guoe2012/cECG/ecg_waveform.png

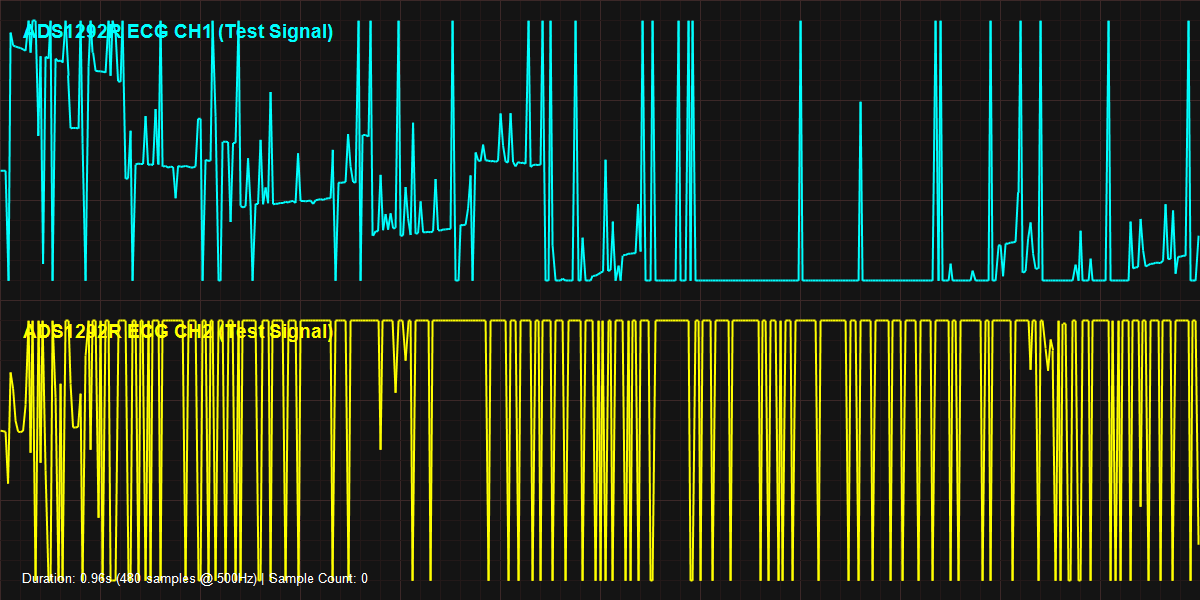
ecg_waveform.png
