guoe2012/cECG/Schematic_V2/Schematic1/SCH_Schematic1_1-sheet_1_Switching DC-DC Conversion_2026-07-18.png

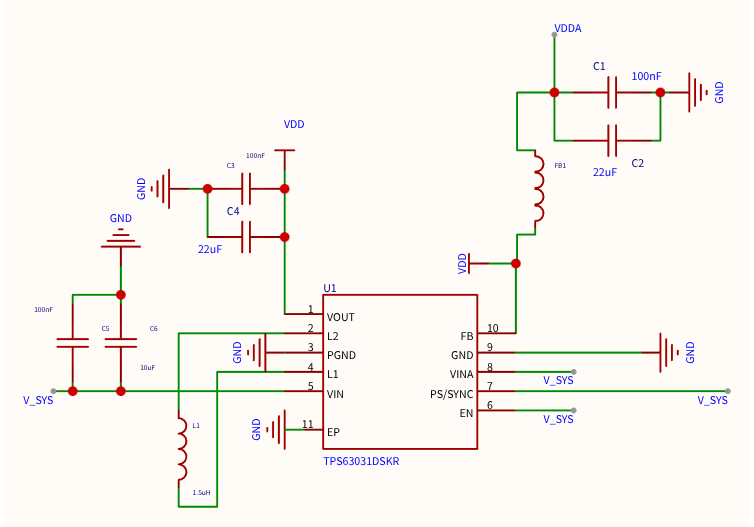
Schematic_V2/Schematic1/SCH_Schematic1_1-sheet_1_Switching DC-DC Conversion_2026-07-18.png
