guoe2012/cECG/Schematic_V2/Schematic1/SCH_Schematic1_2-sheet_2_Battery Management_2026-07-18.png

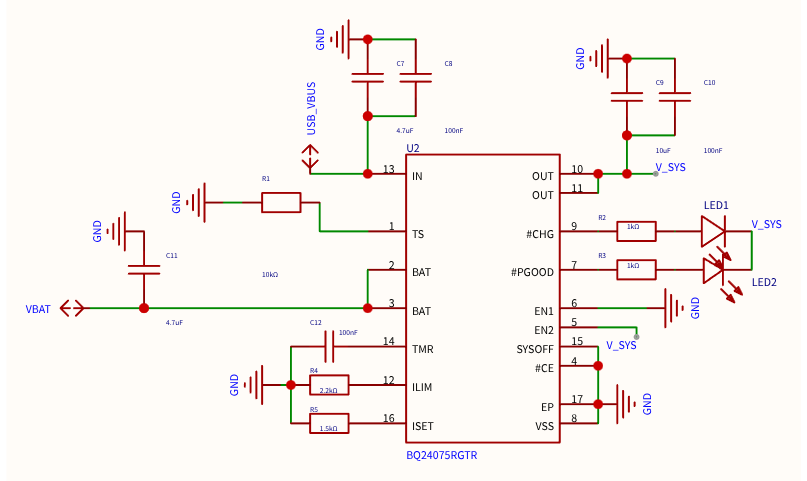
Schematic_V2/Schematic1/SCH_Schematic1_2-sheet_2_Battery Management_2026-07-18.png
