guoe2012/cECG/Schematic_V2/Schematic1/SCH_Schematic1_3-sheet_3_USB Connector_2026-07-18.png

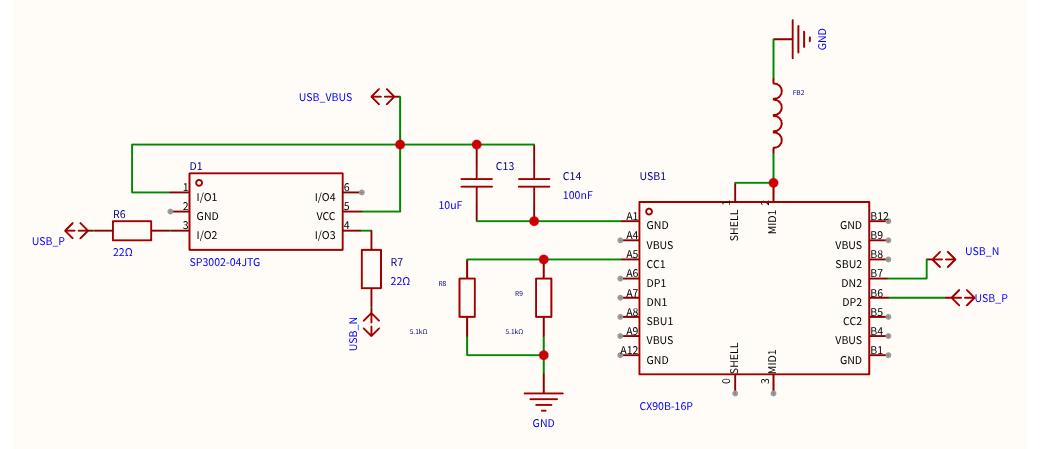
Schematic_V2/Schematic1/SCH_Schematic1_3-sheet_3_USB Connector_2026-07-18.png
