guoe2012/cECG/Schematic_V2/Schematic1/SCH_Schematic1_4-sheet_4_STM32G491RET6 Microcontroller_2026-07-18.png

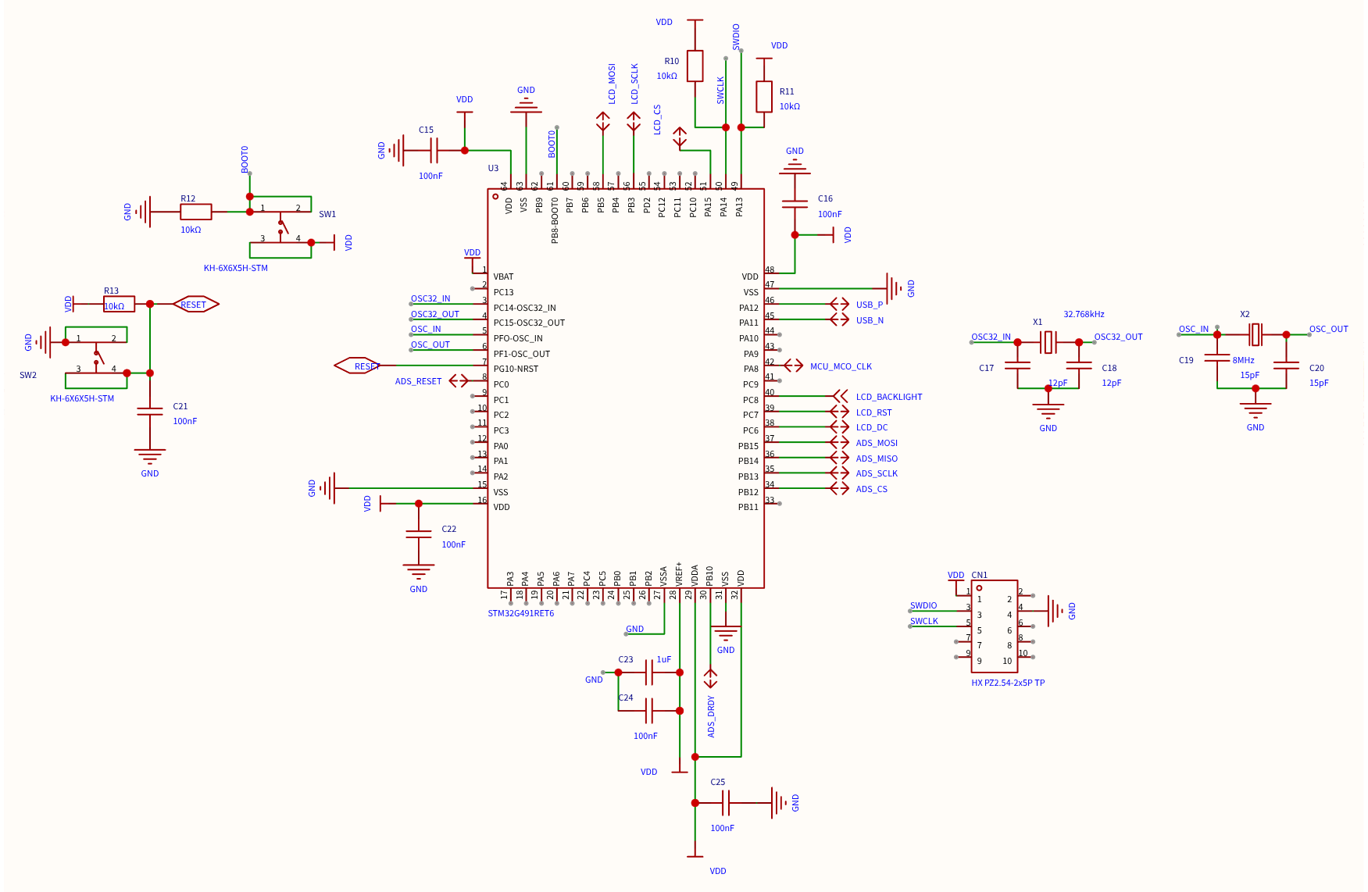
Schematic_V2/Schematic1/SCH_Schematic1_4-sheet_4_STM32G491RET6 Microcontroller_2026-07-18.png
