guoe2012/cECG/Schematic_V2/Schematic1/SCH_Schematic1_5-sheet_6_Batteries_2026-07-18.png

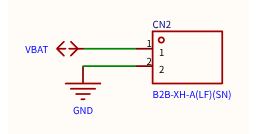
Schematic_V2/Schematic1/SCH_Schematic1_5-sheet_6_Batteries_2026-07-18.png
