guoe2012/cECG/Schematic_V2/Schematic1/SCH_Schematic1_6-sheet_7_Rectangular TFT Display_2026-07-18.png

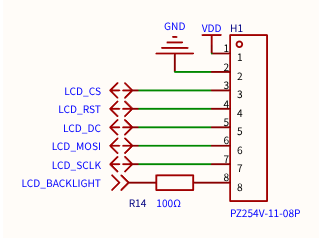
Schematic_V2/Schematic1/SCH_Schematic1_6-sheet_7_Rectangular TFT Display_2026-07-18.png
