guoe2012/cECG/Schematic_V2/Schematic1/SCH_Schematic1_7-sheet_9_ADS1292R_2026-07-18.png

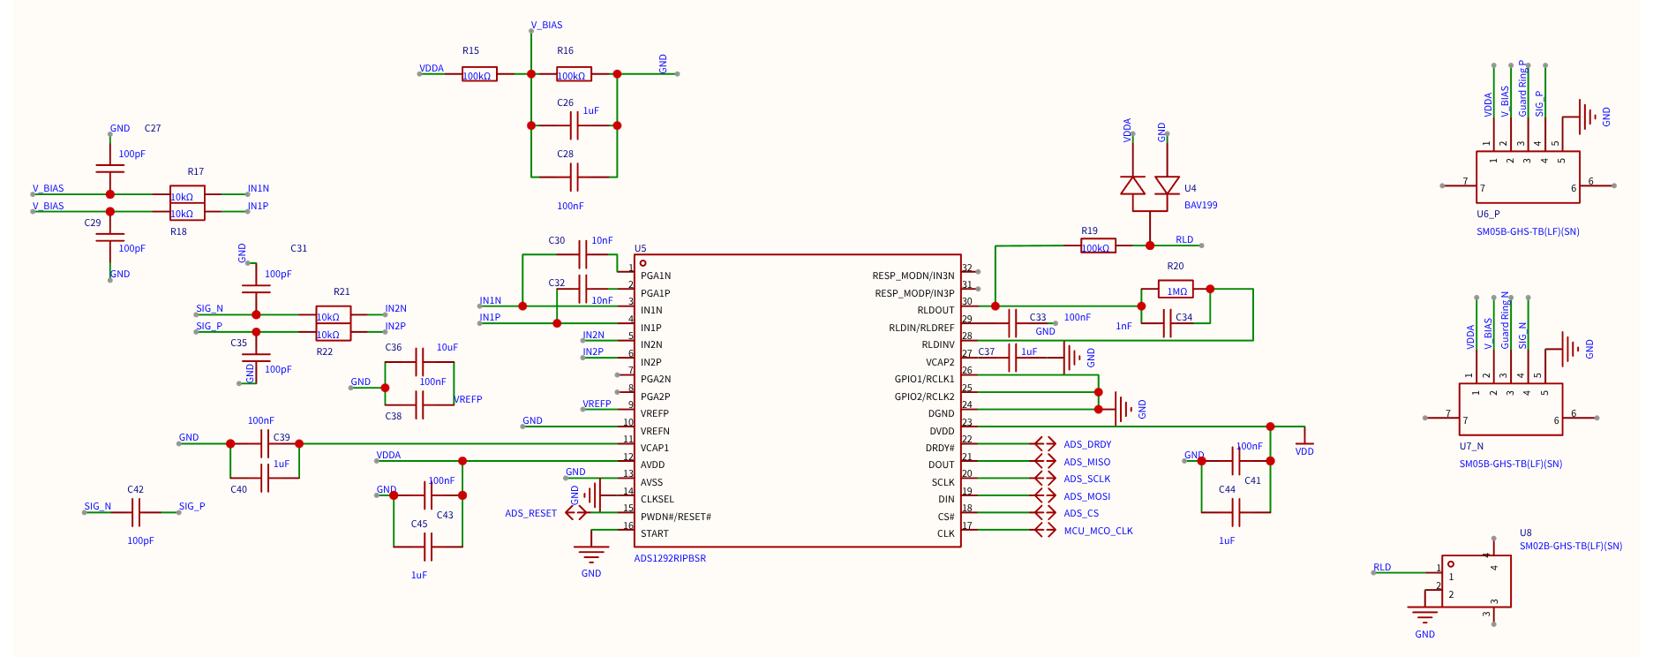
Schematic_V2/Schematic1/SCH_Schematic1_7-sheet_9_ADS1292R_2026-07-18.png
