guoe2012/cECG/Schematic_V2/Schematic2/SCH_Schematic2_1-sheet_5_OPA391_RA_2026-07-18.png

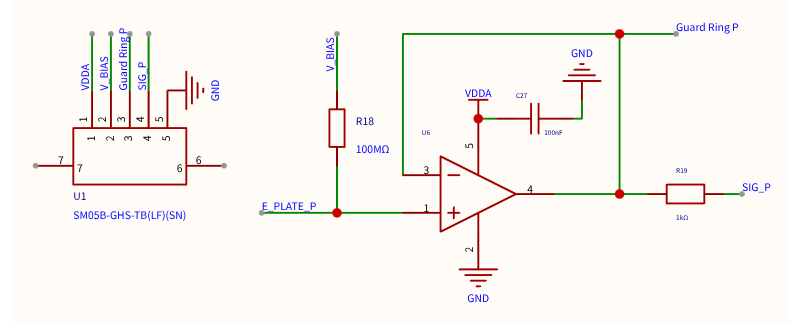
Schematic_V2/Schematic2/SCH_Schematic2_1-sheet_5_OPA391_RA_2026-07-18.png
