guoe2012/cECG/Schematic_V2/Schematic3/SCH_Schematic3_1-sheet_8_OPA391_LA_2026-07-18.png

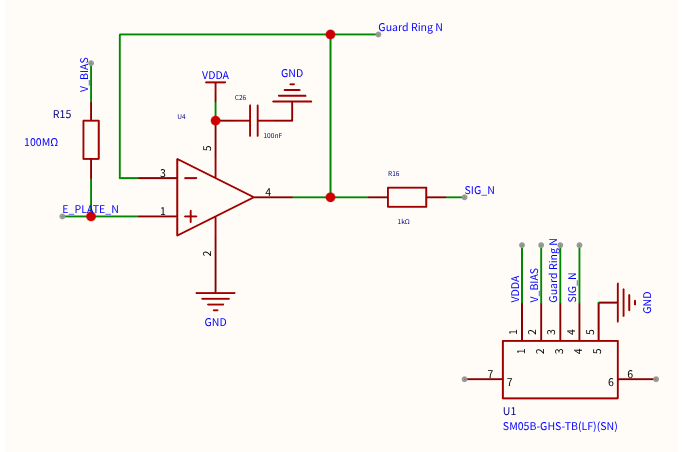
Schematic_V2/Schematic3/SCH_Schematic3_1-sheet_8_OPA391_LA_2026-07-18.png
