guoe2012/cECG/Schematic_V2/Schematic4/SCH_Schematic4_1-P1_2026-07-18.png

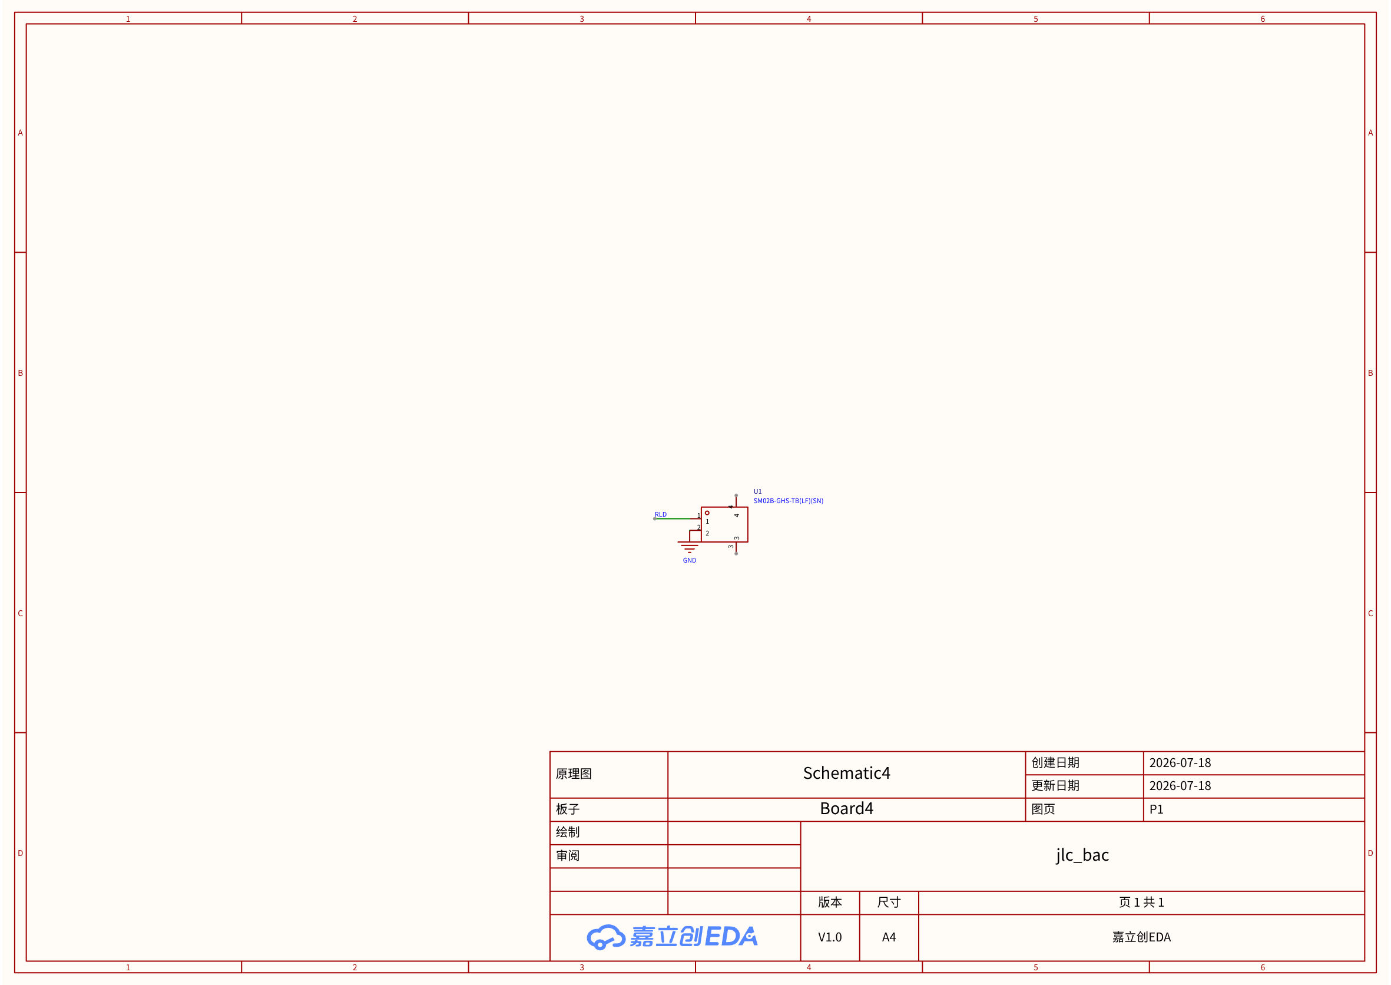
Schematic_V2/Schematic4/SCH_Schematic4_1-P1_2026-07-18.png
