guoe2012/cECG/BOM_Board1_MAIN_PCB1_2026-07-19_V2.xlsx

No. | Quantity | Comment | Designator | Footprint | Value | Manufacturer Part | Manufacturer | Supplier Part | Supplier
1 | 1 | 100nF | C1 | C0603 | 100nF | CGA0603X7R104K500JT | HRE(芯声) | C6119867 | LCSC
2 | 1 | 22uF | C2 | C0603 | 22uF | HGC0603R5226M100NTHJ | Chinocera(华瓷) | C7432770 | LCSC
3 | 1 | 100nF | C3 | C0603 | 100nF | FCC0603B104K500CT | FOJAN(富捷) | C5137636 | LCSC
4 | 1 | 22uF | C4 | C0603 | 22uF | CGA0603X5R226M160JT | HRE(芯声) | C6119868 | LCSC
5 | 1 | 100nF | C5 | C0603 | 100nF | FCC0603B104K500CT | FOJAN(富捷) | C5137636 | LCSC
6 | 1 | 10uF | C6 | C0603 | 10uF | HGC0603R5106M160NTHJ | Chinocera(华瓷) | C7472959 | LCSC
7 | 1 | 4.7uF | C7 | C0603 | 4.7uF | CGA0603X5R475K250JT | HRE(芯声) | C6119856 | LCSC
8 | 1 | 100nF | C8 | C0603 | 100nF | CGA0603X7R104K500JT | HRE(芯声) | C6119867 | LCSC
9 | 1 | 10uF | C9 | C0603 | 10uF | CGA0603X5R106K100JT | HRE(芯声) | C6119842 | LCSC
10 | 1 | 100nF | C10 | C0603 | 100nF | CGA0603X7R104K500JT | HRE(芯声) | C6119867 | LCSC
11 | 1 | 4.7uF | C11 | C0603 | 4.7uF | CGA0603X5R475K250JT | HRE(芯声) | C6119856 | LCSC
12 | 1 | 100nF | C13 | C0603 | 100nF | CC0603KRX7R9BB104 | YAGEO(国巨) | C14663 | LCSC
13 | 1 | 10uF | C14 | C0603 | 10uF | HGC0603R5106M160NTHJ | Chinocera(华瓷) | C7472959 | LCSC
14 | 1 | 100nF | C15 | C0603 | 100nF | CC0603KRX7R9BB104 | YAGEO(国巨) | C14663 | LCSC
15 | 1 | 100nF | C16 | C0603 | 100nF | CC0603KRX7R9BB104 | YAGEO(国巨) | C14663 | LCSC
16 | 1 | 12pF | C17 | C0603 | 12pF | CL10C120JB8NNNC | SAMSUNG(三星) | C38523 | LCSC
17 | 1 | 12pF | C18 | C0603 | 12pF | CL10C120JB8NNNC | SAMSUNG(三星) | C38523 | LCSC
18 | 1 | 15pF | C19 | C0603 | 15pF | CL10C150JB8NNNC | SAMSUNG(三星) | C1644 | LCSC
19 | 1 | 15pF | C20 | C0603 | 15pF | CL10C150JB8NNNC | SAMSUNG(三星) | C1644 | LCSC
20 | 1 | 100nF | C21 | C0603 | 100nF | CC0603KRX7R9BB104 | YAGEO(国巨) | C14663 | LCSC
21 | 1 | 100nF | C22 | C0603 | 100nF | CC0603KRX7R9BB104 | YAGEO(国巨) | C14663 | LCSC
22 | 1 | 1uF | C23 | C0603 | 1uF | CGA0603X5R105K160JT | HRE(芯声) | C6119849 | LCSC
23 | 1 | 100nF | C24 | C0603 | 100nF | CC0603KRX7R9BB104 | YAGEO(国巨) | C14663 | LCSC
24 | 1 | 100nF | C25 | C0603 | 100nF | CC0603KRX7R9BB104 | YAGEO(国巨) | C14663 | LCSC
25 | 1 | 1uF | C26 | C0603 | 1uF | CC0603KRX7R9BB105 | YAGEO(国巨) | C559769 | LCSC
26 | 1 | 100pF | C27 | C0603 | 100pF | CL10C101JB8NNNC | SAMSUNG(三星) | C14858 | LCSC
27 | 1 | 100nF | C28 | C0603 | 100nF | CC0603KRX7R9BB104 | YAGEO(国巨) | C14663 | LCSC
28 | 1 | 100pF | C29 | C0603 | 100pF | CL10C101JB8NNNC | SAMSUNG(三星) | C14858 | LCSC
29 | 1 | 10nF | C30 | C0603 | 10nF | CC0603KRX7R9BB103 | YAGEO(国巨) | C100042 | LCSC
30 | 1 | 100pF | C31 | C0603 | 100pF | CL10C101JB8NNNC | SAMSUNG(三星) | C14858 | LCSC
31 | 1 | 10nF | C32 | C0603 | 10nF | CC0603KRX7R9BB103 | YAGEO(国巨) | C100042 | LCSC
32 | 1 | 100nF | C33 | C0603 | 100nF | CC0603KRX7R9BB104 | YAGEO(国巨) | C14663 | LCSC
33 | 1 | 1nF | C34 | C0603 | 1nF | CC0603JRNPO9BN102 | YAGEO(国巨) | C106246 | LCSC
34 | 1 | 100pF | C35 | C0603 | 100pF | CL10C101JB8NNNC | SAMSUNG(三星) | C14858 | LCSC
35 | 1 | 10uF | C36 | C0603 | 10uF | HGC0603R5106M160NTHJ | Chinocera(华瓷) | C7472959 | LCSC
36 | 1 | 1uF | C37 | C0603 | 1uF | CC0603KRX7R9BB105 | YAGEO(国巨) | C559769 | LCSC
37 | 1 | 100nF | C38 | C0603 | 100nF | CC0603KRX7R9BB104 | YAGEO(国巨) | C14663 | LCSC
38 | 1 | 100nF | C39 | C0603 | 100nF | CC0603KRX7R9BB104 | YAGEO(国巨) | C14663 | LCSC
39 | 1 | 1uF | C40 | C0603 | 1uF | CC0603KRX7R9BB105 | YAGEO(国巨) | C559769 | LCSC
40 | 1 | 100nF | C41 | C0603 | 100nF | CC0603KRX7R9BB104 | YAGEO(国巨) | C14663 | LCSC
41 | 1 | 100pF | C42 | C0603 | 100pF | CL10C101JB8NNNC | SAMSUNG(三星) | C14858 | LCSC
42 | 1 | 100nF | C43 | C0603 | 100nF | CC0603KRX7R9BB104 | YAGEO(国巨) | C14663 | LCSC
43 | 1 | 1uF | C44 | C0603 | 1uF | CC0603KRX7R9BB105 | YAGEO(国巨) | C559769 | LCSC
44 | 1 | 1uF | C45 | C0603 | 1uF | CC0603KRX7R9BB105 | YAGEO(国巨) | C559769 | LCSC
45 | 1 | HX PZ2.54-2x5P TP | CN1 | HDR-SMD_10P-P2.54-V-M-R2-C5-LS7.5 |  | HX PZ2.54-2x5P TP | hanxia(韩下) | C32713285 | LCSC
46 | 1 | B2B-XH-A(LF)(SN) | CN2 | CONN-TH_B2B-XH-A-LF-SN |  | B2B-XH-A(LF)(SN) | JST | C158012 | LCSC
47 | 1 | SP3002-04JTG | D1 | SC-70-6_L2.2-W1.3-P0.65-LS2.1-BR |  | SP3002-04JTG | Littelfuse(美国力特) | C84558 | LCSC
48 | 1 | BLM18PG121SN1D | FB1 | L0603 |  | BLM18PG121SN1D | muRata(村田) | C14709 | LCSC
49 | 1 | BLM18PG121SN1D | FB2 | L0603 |  | BLM18PG121SN1D | muRata(村田) | C14709 | LCSC
50 | 1 | PZ254V-11-08P | H1 | HDR-TH_8P-P2.54-V-M |  | PZ254V-11-08P | XFCN(兴飞) | C492407 | LCSC
51 | 1 | 1.5uH | L1 | IND-SMD_L4.6-W4.1_SRG0420 | 1.5uH | SRG0420-1R5-M | JIERR(捷而瑞) | C53462915 | LCSC
52 | 1 | LTST-C170KRKT | LED1 | LED0805-R-RD |  | LTST-C170KRKT | LITEON(光宝) | C94868 | LCSC
53 | 1 | LTST-C170KGKT | LED2 | LED0805-R-RD |  | LTST-C170KGKT | LITEON(光宝) | C98221 | LCSC
54 | 1 | 10kΩ | R1 | R0603 | 10kΩ | FRC0603J103 TS | FOJAN(富捷) | C2930027 | LCSC
55 | 1 | 1kΩ | R2 | R0603 | 1kΩ | FRC0603F1001TS | FOJAN(富捷) | C2907002 | LCSC
56 | 1 | 1kΩ | R3 | R0603 | 1kΩ | FRC0603F1001TS | FOJAN(富捷) | C2907002 | LCSC
57 | 1 | 2.2kΩ | R4 | R0603 | 2.2kΩ | FRC0603F2201TS | FOJAN(富捷) | C2907005 | LCSC
58 | 1 | 1.5kΩ | R5 | R0603 | 1.5kΩ | FRC0603F1501TS | FOJAN(富捷) | C2930050 | LCSC
59 | 1 | 5.1kΩ | R6 | R0603 | 5.1kΩ | 0603WAF5101T5E | UNI-ROYAL(厚声) | C23186 | LCSC
60 | 1 | 5.1kΩ | R8 | R0603 | 5.1kΩ | 0603WAF5101T5E | UNI-ROYAL(厚声) | C23186 | LCSC
61 | 1 | 10kΩ | R10 | R0603 | 10kΩ | FRC0603J103 TS | FOJAN(富捷) | C2930027 | LCSC
62 | 1 | 10kΩ | R11 | R0603 | 10kΩ | FRC0603J103 TS | FOJAN(富捷) | C2930027 | LCSC
63 | 1 | 10kΩ | R12 | R0603 | 10kΩ | FRC0603J103 TS | FOJAN(富捷) | C2930027 | LCSC
64 | 1 | 10kΩ | R13 | R0603 | 10kΩ | FRC0603J103 TS | FOJAN(富捷) | C2930027 | LCSC
65 | 1 | 100Ω | R14 | R0603 | 100Ω | RC0603FR-07100RL | YAGEO(国巨) | C105588 | LCSC
66 | 1 | 100kΩ | R15 | R0603 | 100kΩ | 0603WAF1003T5E | UNI-ROYAL(厚声) | C25803 | LCSC
67 | 1 | 100kΩ | R16 | R0603 | 100kΩ | 0603WAF1003T5E | UNI-ROYAL(厚声) | C25803 | LCSC
68 | 1 | 10kΩ | R17 | R0603 | 10kΩ | FRC0603F1002TS | FOJAN(富捷) | C2906982 | LCSC
69 | 1 | 10kΩ | R18 | R0603 | 10kΩ | FRC0603F1002TS | FOJAN(富捷) | C2906982 | LCSC
70 | 1 | 100kΩ | R19 | R0603 | 100kΩ | RC0603FR-07100KL | YAGEO(国巨) | C14675 | LCSC
71 | 1 | 1MΩ | R20 | R0603 | 1MΩ | FRR0603J105 TS | FOJAN(富捷) | C49196795 | LCSC
72 | 1 | 10kΩ | R21 | R0603 | 10kΩ | FRC0603F1002TS | FOJAN(富捷) | C2906982 | LCSC
73 | 1 | 10kΩ | R22 | R0603 | 10kΩ | FRC0603F1002TS | FOJAN(富捷) | C2906982 | LCSC
74 | 1 | KH-6X6X5H-STM | SW1 | SW-SMD_4P-L6.0-W6.0-P4.50-LS9.0_H5.0 |  | KH-6X6X5H-STM | kinghelm(金航标) | C2837531 | LCSC
75 | 1 | KH-6X6X5H-STM | SW2 | SW-SMD_4P-L6.0-W6.0-P4.50-LS9.0_H5.0 |  | KH-6X6X5H-STM | kinghelm(金航标) | C2837531 | LCSC
76 | 1 | TPS63031DSKR | U1 | SON-10_L2.5-W2.5-P0.50-TL-EP |  | TPS63031DSKR | TI(德州仪器) | C15516 | LCSC
77 | 1 | BQ24075RGTR | U2 | QFN-16_L3.0-W3.0-P0.50-TL-EP1.7 |  | BQ24075RGTR | TI(德州仪器) | C15464 | LCSC
78 | 1 | STM32G491RET6 | U3 | LQFP-64_L10.0-W10.0-P0.50-LS12.0-BL |  | STM32G491RET6 | ST(意法半导体) | C3231005 | LCSC
79 | 1 | BAV199 | U4 | SOT-23-3_L2.9-W1.3-P0.95-LS2.4-BR |  | BAV199 | HXY MOSFET(华轩阳电子) | C5184419 | LCSC
80 | 1 | ADS1292RIPBSR | U5 | TQFP-32_L5.0-W5.0-P0.50-LS7.0-TL |  | ADS1292RIPBSR | TI(德州仪器) | C528635 | LCSC
81 | 1 | SM05B-GHS-TB(LF)(SN) | U6_P | CONN-SMD_5P-P1.25_SM05B-GHS-TB-LF-SN |  | SM05B-GHS-TB(LF)(SN) | JST | C189896 | LCSC
82 | 1 | SM05B-GHS-TB(LF)(SN) | U7_N | CONN-SMD_5P-P1.25_SM05B-GHS-TB-LF-SN |  | SM05B-GHS-TB(LF)(SN) | JST | C189896 | LCSC
83 | 1 | SM02B-GHS-TB(LF)(SN) | U8 | CONN-SMD_SM02B-GHS-TB-LF-SN |  | SM02B-GHS-TB(LF)(SN) | JST | C189893 | LCSC
84 | 1 | CX90B-16P | USB2 | USB-C-SMD_CX90B-16P |  | CX90B-16P | HRS(广濑) | C3198004 | LCSC
85 | 1 | 32.768kHz | X1 | OSC-SMD_L3.2-W1.5 | 32.768kHz | X321532768KGD2SI | YXC(扬兴晶振) | C620155 | LCSC
86 | 1 | 8MHz | X2 | CRYSTAL-SMD_L3.2-W2.5_3225-8MHZ | 8MHz | X22EL89COI-111YLC-8M | YXC(扬兴晶振) | C42448903 | LCSC
