guoe2012/cECG/build_log.txt

make: Entering directory 'C:/Users/guoe2/Documents/cECG/Debug'
rm -rf ./Src/ads1292r_test.cyclo ./Src/ads1292r_test.d ./Src/ads1292r_test.o ./Src/ads1292r_test.su ./Src/ads_connect_test.cyclo ./Src/ads_connect_test.d ./Src/ads_connect_test.o ./Src/ads_connect_test.su ./Src/ecg_acquisition.cyclo ./Src/ecg_acquisition.d ./Src/ecg_acquisition.o ./Src/ecg_acquisition.su ./Src/ili9488.cyclo ./Src/ili9488.d ./Src/ili9488.o ./Src/ili9488.su ./Src/main.cyclo ./Src/main.d ./Src/main.o ./Src/main.su ./Src/stm32g4xx_hal_msp.cyclo ./Src/stm32g4xx_hal_msp.d ./Src/stm32g4xx_hal_msp.o ./Src/stm32g4xx_hal_msp.su ./Src/stm32g4xx_it.cyclo ./Src/stm32g4xx_it.d ./Src/stm32g4xx_it.o ./Src/stm32g4xx_it.su ./Src/system_stm32g4xx.cyclo ./Src/system_stm32g4xx.d ./Src/system_stm32g4xx.o ./Src/system_stm32g4xx.su
rm -rf ./Drivers/STM32G4xx_HAL_Driver/Src/stm32g4xx_hal.cyclo ./Drivers/STM32G4xx_HAL_Driver/Src/stm32g4xx_hal.d ./Drivers/STM32G4xx_HAL_Driver/Src/stm32g4xx_hal.o ./Drivers/STM32G4xx_HAL_Driver/Src/stm32g4xx_hal.su ./Drivers/STM32G4xx_HAL_Driver/Src/stm32g4xx_hal_adc.cyclo ./Drivers/STM32G4xx_HAL_Driver/Src/stm32g4xx_hal_adc.d ./Drivers/STM32G4xx_HAL_Driver/Src/stm32g4xx_hal_adc.o ./Drivers/STM32G4xx_HAL_Driver/Src/stm32g4xx_hal_adc.su ./Drivers/STM32G4xx_HAL_Driver/Src/stm32g4xx_hal_adc_ex.cyclo ./Drivers/STM32G4xx_HAL_Driver/Src/stm32g4xx_hal_adc_ex.d ./Drivers/STM32G4xx_HAL_Driver/Src/stm32g4xx_hal_adc_ex.o ./Drivers/STM32G4xx_HAL_Driver/Src/stm32g4xx_hal_adc_ex.su ./Drivers/STM32G4xx_HAL_Driver/Src/stm32g4xx_hal_comp.cyclo ./Drivers/STM32G4xx_HAL_Driver/Src/stm32g4xx_hal_comp.d ./Drivers/STM32G4xx_HAL_Driver/Src/stm32g4xx_hal_comp.o ./Drivers/STM32G4xx_HAL_Driver/Src/stm32g4xx_hal_comp.su ./Drivers/STM32G4xx_HAL_Driver/Src/stm32g4xx_hal_cordic.cyclo ./Drivers/STM32G4xx_HAL_Driver/Src/stm32g4xx_hal_cordic.d ./Drivers/STM32G4xx_HAL_Driver/Src/stm32g4xx_hal_cordic.o ./Drivers/STM32G4xx_HAL_Driver/Src/stm32g4xx_hal_cordic.su ./Drivers/STM32G4xx_HAL_Driver/Src/stm32g4xx_hal_cortex.cyclo ./Drivers/STM32G4xx_HAL_Driver/Src/stm32g4xx_hal_cortex.d ./Drivers/STM32G4xx_HAL_Driver/Src/stm32g4xx_hal_cortex.o ./Drivers/STM32G4xx_HAL_Driver/Src/stm32g4xx_hal_cortex.su ./Drivers/STM32G4xx_HAL_Driver/Src/stm32g4xx_hal_crc.cyclo ./Drivers/STM32G4xx_HAL_Driver/Src/stm32g4xx_hal_crc.d ./Dri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
rm -rf ./Drivers/STM32G4xx_HAL_Driver/Src/stm32g4xx_ll_rng.d ./Drivers/STM32G4xx_HAL_Driver/Src/stm32g4xx_ll_rng.o ./Drivers/STM32G4xx_HAL_Driver/Src/stm32g4xx_ll_rng.su ./Drivers/STM32G4xx_HAL_Driver/Src/stm32g4xx_ll_rtc.cyclo ./Drivers/STM32G4xx_HAL_Driver/Src/stm32g4xx_ll_rtc.d ./Drivers/STM32G4xx_HAL_Driver/Src/stm32g4xx_ll_rtc.o ./Drivers/STM32G4xx_HAL_Driver/Src/stm32g4xx_ll_rtc.su ./Drivers/STM32G4xx_HAL_Driver/Src/stm32g4xx_ll_spi.cyclo ./Drivers/STM32G4xx_HAL_Driver/Src/stm32g4xx_ll_spi.d ./Drivers/STM32G4xx_HAL_Driver/Src/stm32g4xx_ll_spi.o ./Drivers/STM32G4xx_HAL_Driver/Src/stm32g4xx_ll_spi.su ./Drivers/STM32G4xx_HAL_Driver/Src/stm32g4xx_ll_tim.cyclo ./Drivers/STM32G4xx_HAL_Driver/Src/stm32g4xx_ll_tim.d ./Drivers/STM32G4xx_HAL_Driver/Src/stm32g4xx_ll_tim.o ./Drivers/STM32G4xx_HAL_Driver/Src/stm32g4xx_ll_tim.su ./Drivers/STM32G4xx_HAL_Driver/Src/stm32g4xx_ll_ucpd.cyclo ./Drivers/STM32G4xx_HAL_Driver/Src/stm32g4xx_ll_ucpd.d ./Drivers/STM32G4xx_HAL_Driver/Src/stm32g4xx_ll_ucpd.o ./Drivers/STM32G4xx_HAL_Driver/Src/stm32g4xx_ll_ucpd.su ./Drivers/STM32G4xx_HAL_Driver/Src/stm32g4xx_ll_usart.cyclo ./Drivers/STM32G4xx_HAL_Driver/Src/stm32g4xx_ll_usart.d ./Drivers/STM32G4xx_HAL_Driver/Src/stm32g4xx_ll_usart.o ./Drivers/STM32G4xx_HAL_Driver/Src/stm32g4xx_ll_usart.su ./Drivers/STM32G4xx_HAL_Driver/Src/stm32g4xx_ll_usb.cyclo ./Drivers/STM32G4xx_HAL_Driver/Src/stm32g4xx_ll_usb.d ./Drivers/STM32G4xx_HAL_Driver/Src/stm32g4xx_ll_usb.o ./Drivers/STM32G4xx_HAL_Driver/Src/stm32g4xx_ll_usb.su ./Drivers/STM32G4xx_HAL_Driver/Src/stm32g4xx_ll_utils.cyclo ./Drivers/STM32G4xx_HAL_Driver/Src/stm32g4xx_ll_utils.d ./Drivers/STM32G4xx_HAL_Driver/Src/stm32g4xx_ll_utils.o ./Drivers/STM32G4xx_HAL_Driver/Src/stm32g4xx_ll_utils.su
rm -rf ./startup_stm32g491xx.d ./startup_stm32g491xx.o
rm -rf cECG.elf cECG.list cECG.map default.size.stdout
 
make: Leaving directory 'C:/Users/guoe2/Documents/cECG/Debug'
