guoe2012/cECG/Schematic_V1/SCH_Schematic1_2026-07-15.pdf

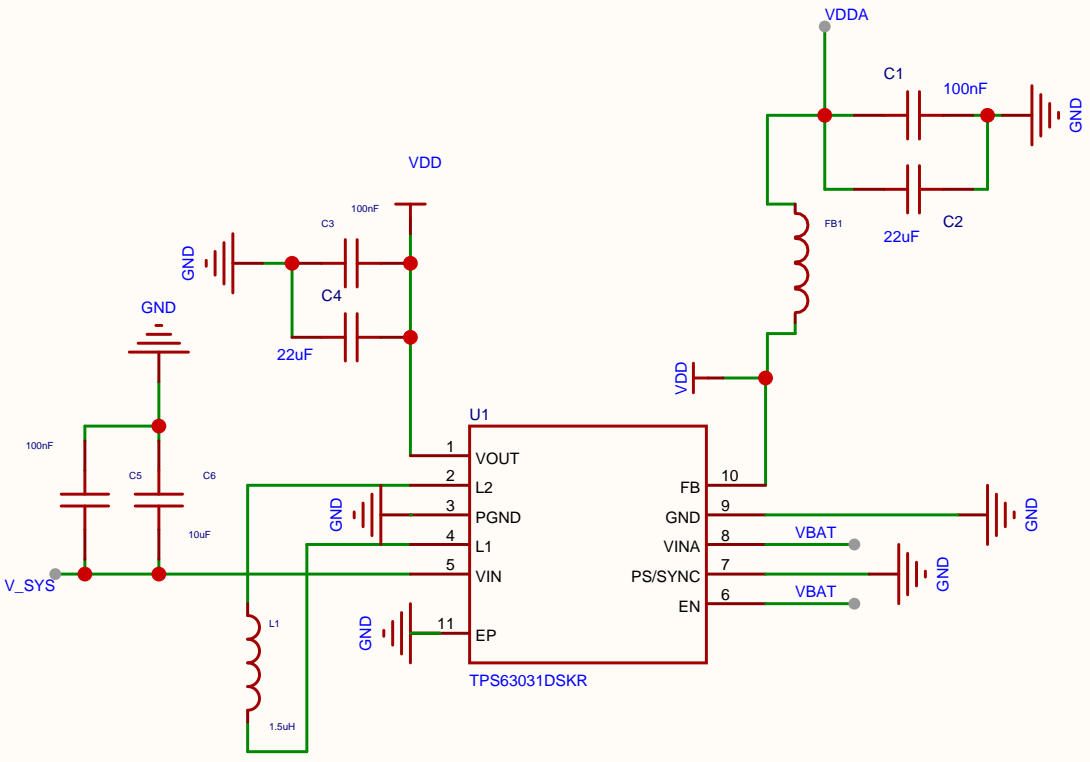
[picture p12: page 1]

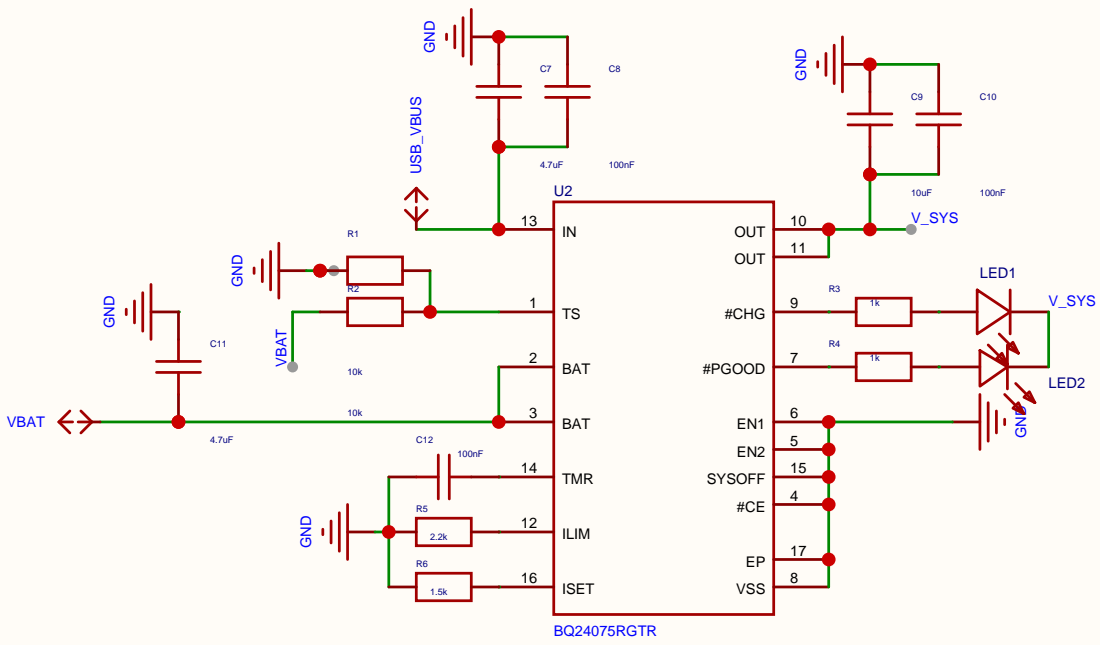
[picture p13: page 2]

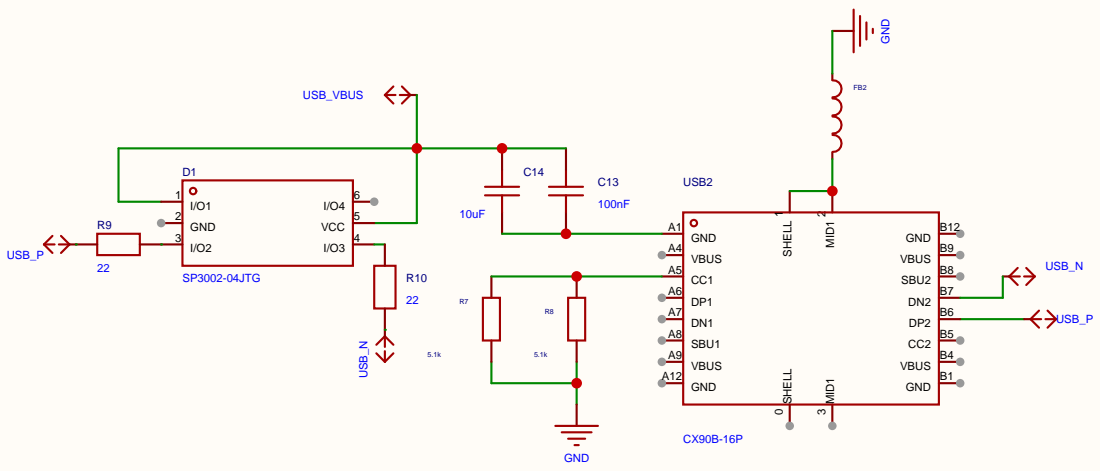
[picture p14: page 3]

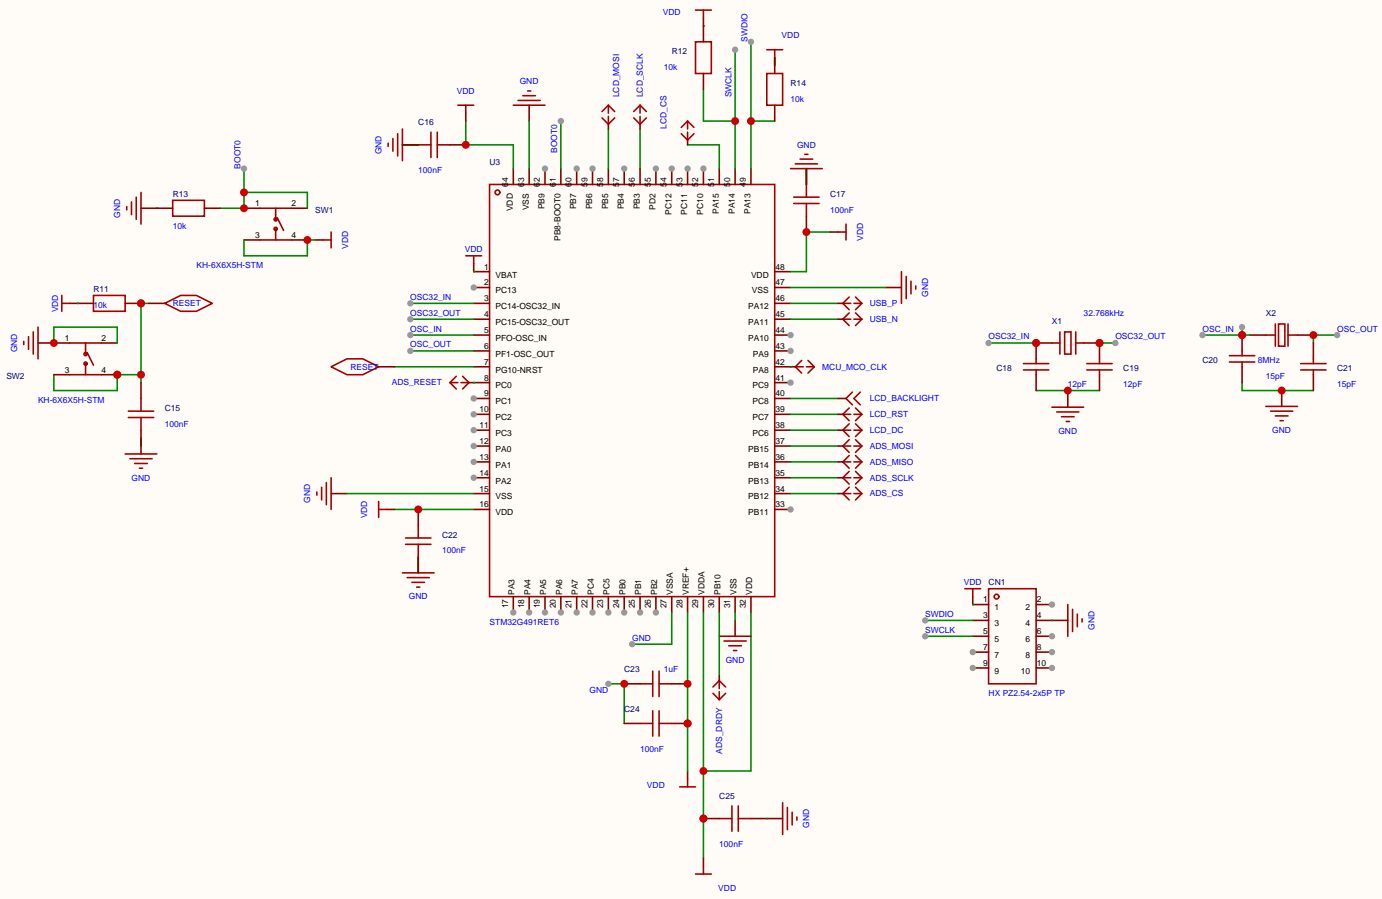
[picture p15: page 4]

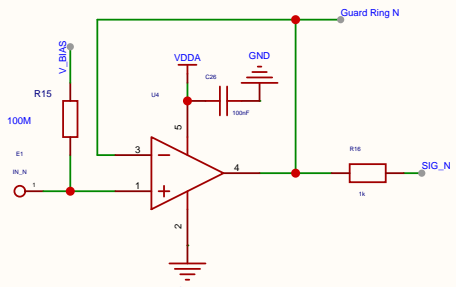
[picture p16: figure]
SIG_N; VDDA; Guard Ring N; GND; V_BIAS

CN2



GND

VBAT

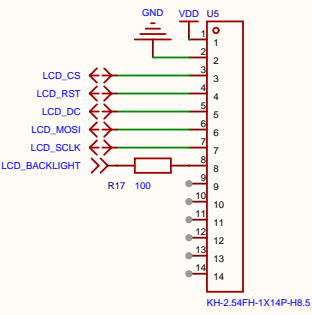
[picture p17: figure]
GND VDD; LCD_RST LCD_DC; LCD_CS; LCD_SCLK; LCD_MOSI; LCD_BACKLIGHT

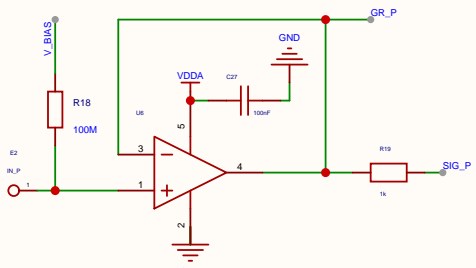
[picture p18: figure]
SIG_P; VDDA; GND; V_BIAS
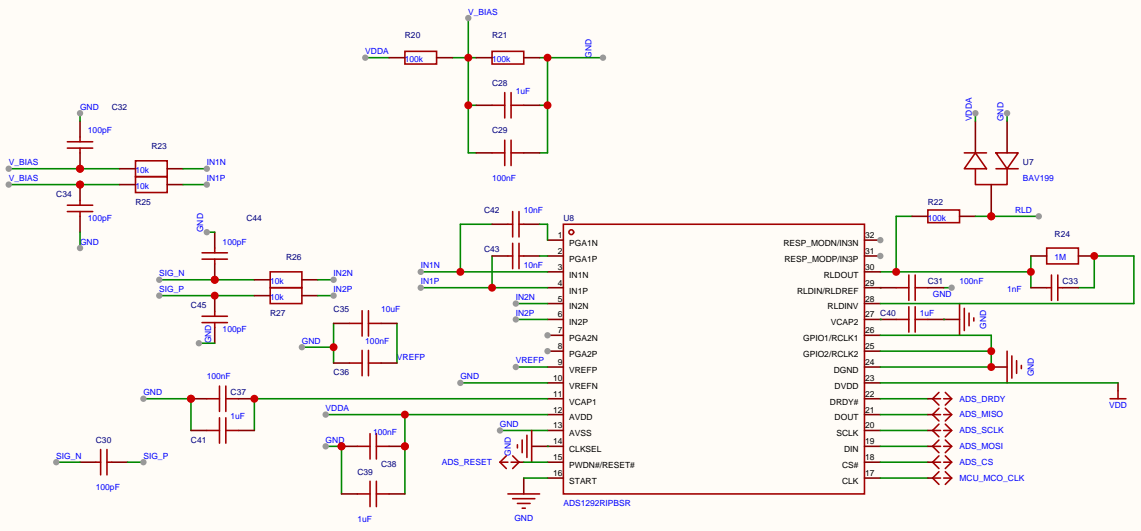
[picture p19: page 9]
