guoe2012/cECG/(commit log)

2026-07-09 Initial commit: cECG STM32G491 firmware project
    [Drill_PTH_Through.DRL, Drill_PTH_Through_Via.DRL, Gerber_BoardOutlineLayer.GKO, Gerber_BottomLayer.GBL, Gerber_BottomPasteMaskLayer.GBP, Gerber_BottomSilkscreenLayer.GBO, Gerber_BottomSolderMaskLayer.GBS, Gerber_TopLayer.GTL]
2026-07-15 feat: USB CDC寄存器读写命令 + DFU支持
    - usbd_cdc_if.c: 添加 R/W 命令解析，通过USB读写ADS1292R寄存器
    - 添加USB CDC/DFU驱动层 (USB_Device/)
    - 添加STM32 USB Device Library (CDC/DFU/Core)
    - dfu_manager: DFU模式切换
    - uart_dump: UART调试输出
    - ecg_acquisition: ECG数据采集优化
2026-07-17 docs: 电极改板清单更新 — 小板原理图定稿/guard ring落地/电极材质结论
    - P路原理图定稿: E_PLATE_P网络、R18 100M偏置、R19串阻、盖油过孔连底层电极
    - 小板PCB要点: 底层专属电极禁其他过孔、guard ring铺铜画法(绕开移除回路)、三防漆
    - 电极材质: 电容式材质无关、沉银≠Ag/AgCl、开窗选沉金
    - 修正外层屏蔽端接: Pin9→D-Sub壳体+GND2(Pin5)单点连接
2026-07-17 docs: 总接头DP9改为GH 9P，电极板接头定型GH 1.25，新增线缆制作方案
    - DP9方案按修订约定用删除线废弃(保留原文)，改用GH 9P单排线性针位
    - 电极板接头定型: 5P SM05B-GHS-TB / 2P SM02B-GHS-TB (必须SMD，底层电极禁通孔)
    - 新增7.1三段式线缆制作: 预压线+同轴接驳映射+工艺要点
    - 外屏蔽端接从D-Sub壳体改为GH Pin9(GND2)，RLD针位改回Pin8
2026-07-20 fix: ADS1292R CH2SET增益字段解析错误，数据导出迁移到USB CDC
    - CH2SET=0x60/0x65实际对应增益6而非1，MUX位与增益位此前混淆，改为0x00/0x05
    - uart_dump从USART2迁移到USB CDC输出，不再需要串口线
    - 链接脚本新增.noinit段，软复位后RAM数据存活
    - 更新电极改板设计文档: 总接头改为主板分立3座(2×5P+1×2P直通线)，新增CN1调试口NRST引出规划
    - 清理不再使用的本地编辑器配置文件，新增.gitignore排除调试临时产物
    [cECG Debug.cfg]
2026-07-20 docs: 新增STM32_USB_Device_Library参考库
2026-07-20 docs: 新增BOM V1/V2
    [BOM_Board1_MAIN_PCB1_2026-07-19_V2.xlsx, BOM_Board1_PCB1_2026-06-25_V1.xlsx]
2026-07-20 docs: 新增Schematic_V1原理图导出
2026-07-20 docs: 新增Schematic_V2原理图导出
2026-07-20 docs: 新增STM32G491RET6数据手册
2026-07-20 docs: 新增ADS1292数据手册
2026-07-20 chore: build_linux/ 编译产物不再入库
    从git历史中彻底剔除build_linux/(此前47MB二进制目标文件是push反复失败的主因)。
    本地build_linux/已用 ./build.sh 重新生成，不受影响。
2026-07-21 chore: 移除Debug/编译中间产物入库, 更新主板BOM V2并新增按Value整理版
    - Debug/(STM32CubeIDE编译输出, 196个.cyclo/.su/.map/.elf等文件)不再入库, 补充进.gitignore
    - BOM_Board1_MAIN_PCB1_2026-07-19_V2.xlsx: 按位号拆分为一行一个, 从小到大排序
    - 新增BOM_v2_value.xlsx: 按Value合并同值元件, 便于识别哪些位号共用同一物料
    [BOM_Board1_MAIN_PCB1_2026-07-19_V2.xlsx, BOM_v2_value.xlsx]
